yezehao/Compact-Continuum-Manipulator-Platform/Gantt-Chart/README.md

# 📋 Project Planning
This is the project planning section. The Gantt chart and Milestones about this project are listed as follow.
## Gantt Chart
```mermaid
gantt
    dateFormat  YYYY-MM-DD
    title MECH0064 MSc Group Project Gantt Chart

    Mataining this Gantt Chart [Z. Ye] : 2023-10-16, 2024-03-22

    section Preliminary Preparation [Z. Ye]
    Literature Review: done, 2023-10-23, 2023-12-31
    Work Package Distrubution: done, 2023-11-13, 5d
    Literature Review: milestone, crit, done, 2023-12-31, 0d 

    section Environment Config [Z. Ye]
    GitHub Config: done, 2023-11-6, 10d
    LaTex Config: done, 2023-11-13, 10d
    Docker Container Config: done, 2023-11-20, 25d
    Environment Configuration: milestone, done, crit, 2023-12-15, 0d 

    section Manipulator Modelling [D. Xu, J. Wu & Y. Zhang] 
    CAD Modelling (2D): done, 2023-11-18, 25d
    UG/Solidwork Modelling (3D): done, 2023-11-23, 25d
    Strain Analysis Replication: done, 2023-12-15, 40d
    Manipulator Model Strain Analysis: done, 2023-12-25, 55d
    Manipulator Model Parameter Adjustment: done, 2024-02-01, 2024-03-01
    Model Physical Strength Verification: milestone, crit, 2024-03-01, 0d 

    section Electronic Components Control [Y. Li & Y. Zhang]
    Proteus & Arduino IDE Env Config: done, 2023-11-18, 12d
    Auctutor Control Simulation: done, 2023-11-30, 10d
    Arduino Programming of Kinematics: done, 2023-12-11, 60d
    Arduino Programme Testing: done, 2024-02-01, 30d
    Arduino Bench Inspection: milestone, crit, 2024-03-01, 0d 

    section Locomotion Model [Z. Ye & Y. Zhu]
    Manipulator Parameter Design: done, 2023-11-18, 14d
    Forward Kinematics Algorithm: done, 2023-12-01, 30d
    Inverse Kinematics Algorithm: done, 2024-01-01, 60d
    Locomotion Bench Inspection: milestone, crit, 2024-03-08, 0d 

    section GitHub Documentation [Z. Ye]
    README Maintanence: active, 2023-10-16, 2024-03-15
    Manipulator Model Strain Analysis Documentation: active, 2024-01-20, 2024-03-15
    Arduino Programme Documentation: active, 2024-01-20, 2024-03-15
    Kinematics Programme Documentation: active, 2024-01-20, 2024-03-15
    Documentation Inspection: milestone, crit, 2024-03-15, 0d 

    section Deliverable
    Presentation 1 Preparation: done, 2023-12-06, 5d
    Presentation 1 [Week 16]: milestone, done, crit, 2023-12-11, 0d 
    Peer Assessment 1 [Week 16]: milestone, done, crit, 2023-12-18, 0d 
    Report Writting Preparation: done, 2024-02-26, 10d 
    Individual Contirbution [Week 28]: done, milestone, crit, 2024-03-08, 0d 
    Final Report [Week 28]: done, milestone, crit, 2024-03-08, 0d 
    Peer Assessment 2 [Week 28]: done, milestone, crit, 2024-03-08, 0d
    Presentation 2 preparation: 2024-03-15, 0d 
    Second Presentation [Week 29]: milestone, crit, 2024-03-15, 0d 
```

## Deadlines
<details closed>
<summary>Deadlines of project</summary>

|Assessment elements|Assessment Type|Contribution|Due Date|
|:--|:--|:--|:--|
|Presentation 1|Formative|Team|2023-12-11|
|Peer Assessment 1|Formative|Individual|2023-12-18|
|Final Report|Summative|Team|2024-03-08|
|Peer Assessment 2|Summative|Individual|2024-03-08|
|Individual Contribution|Summative|Individual|2024-03-08|
|Presentation 2|Summative|Team|2024-03-15|

</details>
