yezehao/Compact-Continuum-Manipulator-Platform/Deliverable/Final-Report/Main-Thesis-File.tex

\documentclass[12pt]{report} % 12 pt front size
\input{config/general.tex} % general config
\input{config/code-block.tex} % code block config
\input{config/flow-chart.tex} % flow chart config

\begin{document} % beginning of the document
\input{Section/Cover-Page} % Cover Page
\input{Section/Abstract} % Abstract
\input{Section/Contents-List} % Contents, List of Figures, and List of Tables
\input{Section/Introduction} % Introduction
\input{Section/Literature-Review} % Literature Review
\input{Section/Design} % Design
\input{Section/Result} % Result and Discussion
\input{Section/Evaluation} % Evaluation
\input{Section/Conclusion} % Conclusion

\setcounter{page}{1}
\renewcommand{\bibname}{References}
\addcontentsline{toc}{chapter}{References}
\pagenumbering{roman}
\pagestyle{plain}
% \printbibliography[title = {References}] % References
\bibliographystyle{unsrt}
\bibliography{references}{}
\newpage
\appendix
\input{Appendix/Appendix1} % Appendix 1
\input{Appendix/Appendix2} % Appendix 2
\input{Appendix/Appendix3} % Appendix 3
\input{Appendix/Appendix4} % Appendix 4
\input{Appendix/Appendix5} % Appendix 5

\end{document}
