yezehao/Compact-Continuum-Manipulator-Platform/Deliverable/Final-Report/Section/Cover-Page.tex

% ==================== Start of Cover Page ==================== %
\begin{titlepage}
\begin{center}
        \begin{center}
        
        \vspace{0.5cm}
        \end{center}
        \vspace*{0.1cm}
        % Title
        \vspace{2cm}
        {\LARGE\textbf{MECH0064 MSc Group Design Project\\}}

        % Sub-Title
        \vspace{2cm}
        {\huge\textbf{A Compact Continuum Robotics Manipulator for Applications in Therapeutic Ultrasound\\}}
        \vspace{0.25cm}
        % {\Huge\textbf{Manipulator Platform\\}}

        \vfill

        \begin{flushleft}
        \textbf{\emph{Group members:}} \\
        Zehao Ye (23119333)~~ Dawei Xu (23068563)\\ 
        Jiachen Wu (23212485)~~ Yuantong Li (23070439)\\ 
        Yuehan Zhang (23060335)~~ Yuhao Zhu (23041703)\\ 
        \textbf{\emph{Supervised by} Dr Reza Haqshenas} \\
        \vspace{5mm}
        \textbf{word count: 12,009}
        \end{flushleft}
        \vspace{0.8cm}
\end{center}
\end{titlepage}
% ==================== End of Cover Page ==================== %
