yezehao/Compact-Continuum-Manipulator-Platform/Deliverable/Final-Report/Appendix/Appendix2.tex

%%%%% Design %%%%%
\chapter{The Code Display}
\label{append:code_display}
\begin{figure}[H] %[H] "corresponds to start the figure Here" 
    \centering %alignment can be flushleft or flushright
    \captionsetup{labelsep=colon}
    \begin{subfigure}{\textwidth} % subfigure 2
        \centering
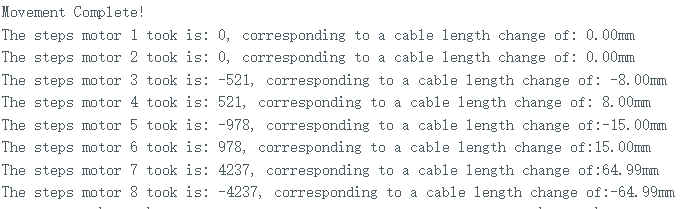
[picture p31: Deliverable/Final-Report/Image/Code-Display/arduino2.png]
        
        \caption{\centering the result of first stepping test}
        \label{fig:arduino_code_display_2}
    \end{subfigure}
    \begin{subfigure}{\textwidth} % subfigure 3
        \centering
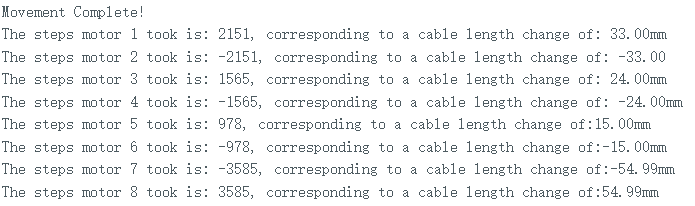
[picture p32: Deliverable/Final-Report/Image/Code-Display/arduino3.png]
        
        \caption{\centering the result of second stepping test}
        \label{fig:arduino_code_display_3}
    \end{subfigure}
    \caption[]
    {\centering \textbf{The Display of Arduino Control System.}}
    \label{fig:arduino_code_display}
\end{figure}

\begin{figure}[H] %[H] "corresponds to start the figure Here" 
    \centering %alignment can be flushleft or flushright
    \captionsetup{labelsep=colon}
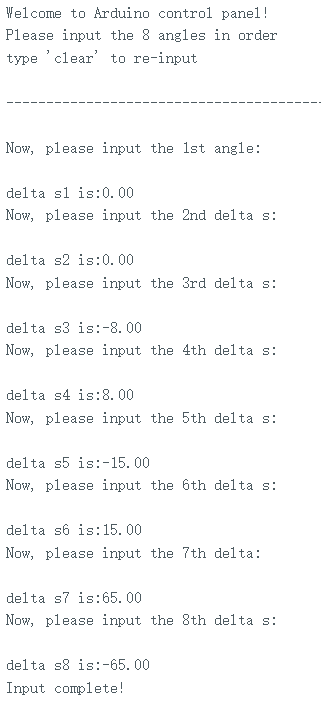
[picture p33: Deliverable/Final-Report/Image/Code-Display/arduino1.png]
    
    \caption[]
    {\centering \textbf{The input parameters for first stepping test.}}
    \label{fig:arduino_code_display_1}
\end{figure}

\begin{figure}[H] %[H] "corresponds to start the figure Here" 
    \centering %alignment can be flushleft or flushright
    \captionsetup{labelsep=colon}
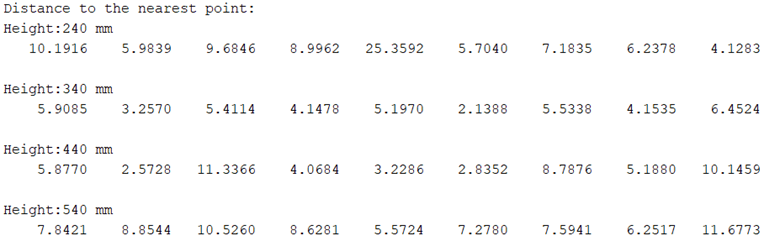
[picture p34: Deliverable/Final-Report/Image/Code-Display/matlab_240.png]
    
    \caption[]
    {\centering \textbf{The detection result while index=1000000 and H=240.}}
    \label{fig:matlab_240}
\end{figure}
\begin{figure}[H] %[H] "corresponds to start the figure Here" 
    \centering %alignment can be flushleft or flushright
    \captionsetup{labelsep=colon}
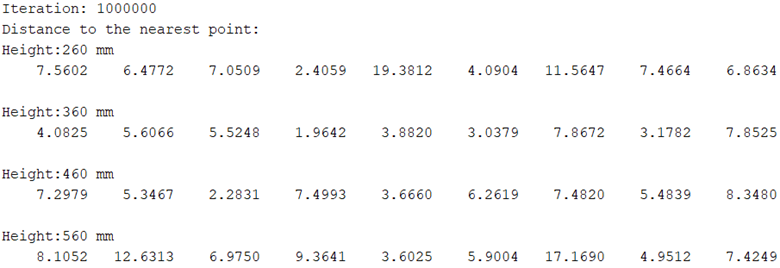
[picture p35: Deliverable/Final-Report/Image/Code-Display/matlab_260.png]
    
    \caption[]
    {\centering \textbf{The detection result while index=1000000 and H=260.}}
    \label{fig:matlab_260}
\end{figure}
\begin{figure}[H] %[H] "corresponds to start the figure Here" 
    \centering %alignment can be flushleft or flushright
    \captionsetup{labelsep=colon}
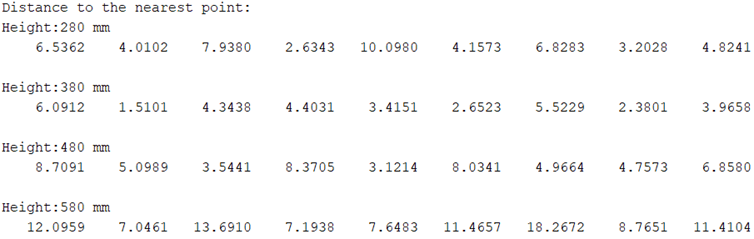
[picture p36: Deliverable/Final-Report/Image/Code-Display/matlab_280.png]
    
    \caption[]
    {\centering \textbf{The detection result while index=1000000 and H=280.}}
    \label{fig:matlab_280}
\end{figure}
\begin{figure}[H] %[H] "corresponds to start the figure Here" 
    \centering %alignment can be flushleft or flushright
    \captionsetup{labelsep=colon}
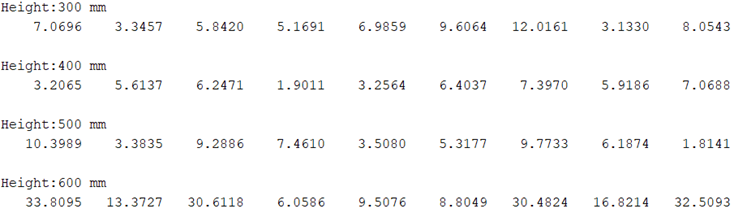
[picture p37: Deliverable/Final-Report/Image/Code-Display/matlab_300.png]
    
    \caption[]
    {\centering \textbf{The detection result while index=1000000 and H=300.}}
    \label{fig:matlab_300}
\end{figure}

% change to new page
\newpage
