yezehao/Compact-Continuum-Manipulator-Platform/Deliverable/Final-Report/config/flow-chart.tex

% This is the defination of flow chart
\usepackage{tikz}
\usetikzlibrary{arrows.meta, shapes.geometric}
\tikzset{%
     >={Latex[width=2mm,length=2mm]},
     % Specifications for style of nodes:
     base/.style = {rectangle, rounded corners, draw=black,
          minimum width=4cm, minimum height=1cm,
          text centered},
     activityStarts/.style = {base},
     startstop/.style = {base, fill=red!30},
     activityRuns/.style = {base},
     process/.style = {base, minimum width=2.5cm},
     data/.style = {rectangle, draw=black, minimum width=4cm, minimum height=1cm, 
          text centered, fill=orange!15},
     pending/.style = {diamond, draw=black, minimum width=1cm, minimum height=1cm, text centered, fill=blue!10},
}
