yezehao/Compact-Continuum-Manipulator-Platform/Deliverable/Final-Report/Image/MATLAB/manipulator_90_90_-90_-90.png

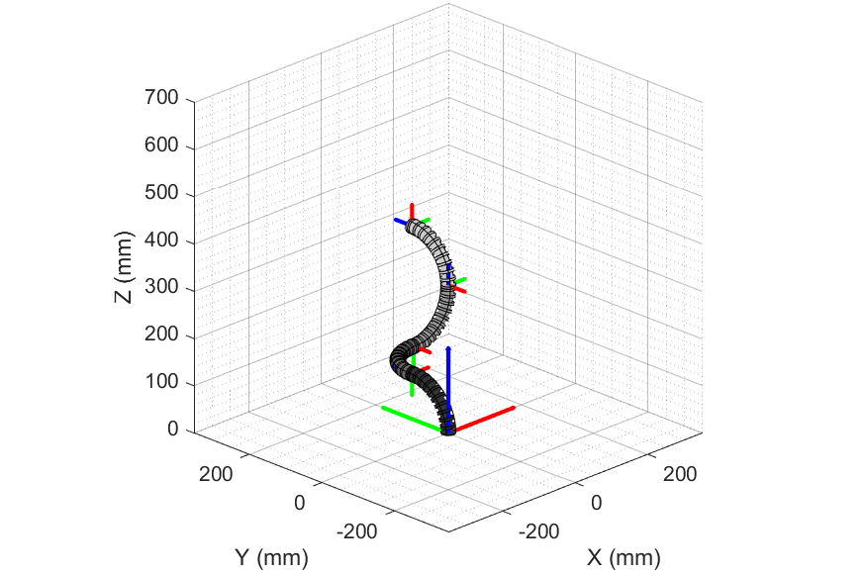
Deliverable/Final-Report/Image/MATLAB/manipulator_90_90_-90_-90.png
