yezehao/Compact-Continuum-Manipulator-Platform/Model/Manipulator.SLDASM

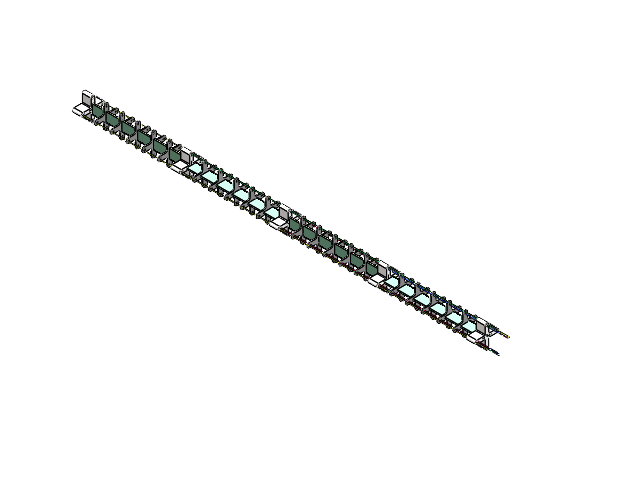
[picture p66: CAD file, 2024-03-07]
Model/Manipulator.SLDASM
Elastic sheet x 4
Soft sleeve x 4
Cross-shaped sheet x 20
Connector x 5
Cable x 8
