yezehao/Compact-Continuum-Manipulator-Platform/Deliverable/Final-Report/Section/Result.tex

%%%%% Result and Discussion %%%%%
\section{Result and Discussion} 
%%%%% Strength Analysis %%%%%
\subsection{Strength Analysis}
\subsubsection{The Result of Strength Analysis}
The strength analysis conducted using ANSYS has yielded the following results.
\begin{itemize}
    \item Displacement \\
    The maximum displacement observed in the manipulator was 117.44 mm, located at the end-effector, which is shown 
    in Figure \ref{fig:displacement}.
    \begin{figure}[H] % figure
        \centering 
        \captionsetup{labelsep=colon}
         
        \caption[The displacement analysis of manipulator]
        {\centering \textbf{The displacement analysis of manipulator.}}
        \label{fig:displacement}
    \end{figure}
    \item Stress \\
    As shown in Figure \ref{fig:stress}, the maximum stress was found to be 476.63 MPa, occurring at the base of 
    elastic sheet where the manipulator experiences the most significant load. 
    \begin{figure}[H] % figure
        \centering 
        \captionsetup{labelsep=colon}
         
        \caption[The stress analysis of manipulator]
        {\centering \textbf{The stress analysis of manipulator.}}
        \label{fig:stress}
    \end{figure}
\end{itemize}

The results indicate that Maximum stress is concentrated on the elastic sheet of the manipulator near the 
connector, which suggests that this is the most likely location for failure under the current design and 
loading conditions. The maximum von Mises stress did not exceed the typical yield strength of 65Mn alloy 
teel, indicating that the arm would return to its original shape after the removal of the load and there is 
no potential risk of plastic deformation or failure. This enhances the arm's reliability and extends its 
operational lifespan. 

Given that the material remains within its elastic limit, the design could potentially be optimized further 
to reduce weight or increase load capacity. Future work may explore these possibilities while maintaining 
the safety factors within the design criteria.
\subsubsection{Limitations and Solutions}
\begin{itemize}
    \item Simplification of the Model \\
    The initial analysis simplified the complex structure of the manipulator by focusing on a single module, 
    potentially overlooking critical interactions between various modules that contribute to the overall 
    strength and performance of the system. This simplification, while beneficial for computational efficiency, 
    may not accurately reflect the integrated behavior of the manipulator in real-world scenarios where interactions 
    between modules can significantly influence outcomes. 
    \textit{Solution}: Future analyses could incorporate the interactions between all modules to provide a more 
    comprehensive understanding of the manipulator's behavior under various conditions. Such an approach will 
    ensure a more accurate representation of the manipulator's behavior under various operational conditions, 
    leading to more reliable performance predictions and informed design decisions. 
    \item Failure Point Concentration \\
    Stress concentration at the base of the elastic sheet indicates a potential failure point but does not 
    account for fatigue or long-term wear. This oversight could underestimate the long-term durability of 
    the manipulator, potentially leading to unexpected maintenance issues or failure. \\
    \textit{Solution}: To address this gap, incorporating a detailed fatigue analysis into future work is 
    crucial. This analysis should evaluate the impact of repeated stress cycles on the manipulator's components 
    over extended periods. By understanding these effects, design modifications can be implemented to enhance 
    the durability and operational lifespan of the manipulator. The modifications could include optimizing 
    material selection, redesigning stress-prone areas to reduce concentration points, and introducing preventive 
    maintenance schedules based on predicted failure. 
    \item Impact of cables \\
    The analysis did not consider the impact of cable tension on the manipulator's strength. Cable tension 
    can significantly affect the manipulator's mechanical behavior. Neglecting this factor may lead to an 
    incomplete understanding of the manipulator's operational capabilities and potential failure modes. \\
    \textit{Solution}: Future analyses should integrate the effects of cable tension to achieve a more accurate 
    assessment of the manipulator's performance. This could involve modifying the existing model to include 
    boundary conditions that accurately represent the forces exerted by cables under various load scenarios. 
    Implementing dynamic simulations that account for variations in tension forces during different stages of 
    operation will further enhance the fidelity of the model. These improvements will enable a more nuanced 
    understanding of the manipulator's capabilities, assisting in the design of a more robust and reliable 
    system capable of withstanding the complexities of real-world applications. 
\end{itemize}
%%%%% Error Analysis %%%%%
\subsection{Error Analysis of Cross-Shaped Sheets}
At the early stage of the project, given that the number of cross-shape sheets in each module have an 
influence on the maximum bending angle $\boldsymbol{\alpha}_{max}$, which is an essential parameter of those which 
affect the workspace of the manipulator, hence the number of sheets should be determined by deriving 
the functions of both absolute error and relative error \cite{fishboneCR} against the number of sheets. The 
simulation results are shown in Figure \ref{fig:error_analysis}.
\begin{figure}[H] % figure
    \centering 
    \captionsetup{labelsep=colon}
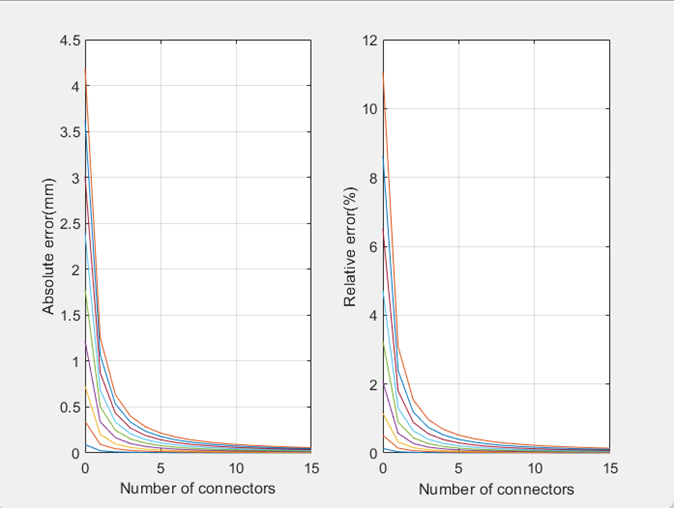
[picture p68: Deliverable/Final-Report/Image/Result/error_analysis.png]
     
    \caption[The simulation results of errors against the number of sheets]
    {\centering \textbf{The simulation results of errors against the number of sheets.}}
    \label{fig:error_analysis}
\end{figure}
As illustrated in Figure \ref{fig:error_analysis}, the changing trends of both absolute and 
relative errors are almost identical since 
the relative error is proportional to the absolute error, and the different lines with different colors represent 
the data with different bending angles whose range is from 10 degrees to 90 degrees in both directions (positive 
or negative). It is obvious that both errors decrease with the increase in the number of connecting sheets, hence 
theoretically, the number of sheets should be as large as possible to make both errors could be negligible. However, 
the number of sheets also has an influence on the size of simulation space, more the number of sheets less the size 
of simulation space given that if the length of manipulator is much longer, the space near to the basement of 
manipulator could not be reached due to the characteristics of the material. Hence, the number of sheets could be 
assumed to be 10 rather than 15, even though both the errors are smaller when the number of sheets is 15. 
%%%%% Workspace Analysis %%%%%
\subsection{Manipulator Workspace Analysis}
The workspace simulation of the manipulator has been illustrated since it is important to determine the 
variables of joints based on the required workspace. The segmented workspace is affected by several aspects, 
which include the simulation index and the range within the three-dimensional coordinates. The effective workspace 
of the manipulator is a cubic whose dimension is 300x300x300 (mm). The specific workspace has a fixed range on 
the x and y axes from -150 to 150 mm. Therefore, it is only necessary to determine the range of the workspace 
along the z-axis. The parameter H, representing the height of the basement of specific workspace, is 
utilized to determine the range of the workspace along the z-axis. The impacts of different indices and 
parameter H will be discussed separately, aiming to segment the appropriate cubic workspace of the manipulator.
\begin{figure}[H] % figure
    \centering 
    \captionsetup{labelsep=colon}
    \begin{subfigure}{0.45\textwidth} % subfigure 1
        \centering
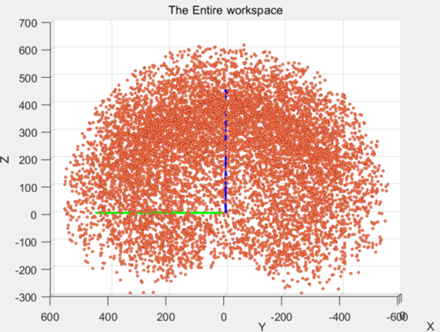
[picture p69: Deliverable/Final-Report/Image/Result/workspace_10000.png]
        
        \caption{\centering The entire workspace where simulation index=10000}
        \label{fig:ws_10000}
    \end{subfigure}
    \hfill
    \begin{subfigure}{0.45\textwidth} % subfigure 2
        \centering
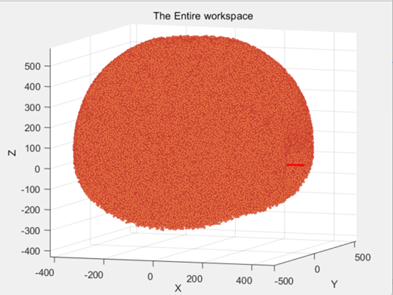
[picture p70: Deliverable/Final-Report/Image/Result/workspace_1000000.png]
        
        \caption{\centering The entire workspace where simulation index=1000000}
        \label{fig:ws_1000000}
    \end{subfigure}
    \caption[The entire workspace with different random indices]
    {\centering \textbf{The entire workspace with different simulation indices.}}
    \label{fig:ws_diff}
\end{figure}
\vspace{-5mm}
As shown in Figure \ref{fig:ws_10000}, the working space of manipulator forms a spherical shell-shaped 
point cloud consisting of 10000 floating points since the simulation index is 10000, which is insufficient to fully 
occupied the theoretical workspace. To further generalize the theoretical workspace, it is necessary to increase 
the simulation index. The appropriate workspace should be divided from the workspace whose index is 1000000. 
\begin{figure}[H] % figure
    \centering 
    \captionsetup{labelsep=colon}
    \begin{subfigure}{0.45\textwidth} % subfigure 2
        \centering
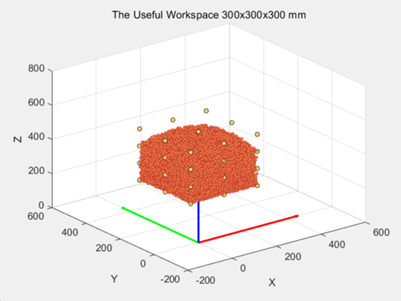
[picture p71: Deliverable/Final-Report/Image/Result/rect_workspace_1000000_350-650.png]
        
        \caption{\centering The cubic workspace of manipulator with index = 1000000 H=350-650 mm}
        \label{fig:ws_1000000_350}
    \end{subfigure}
    \hfill
    \begin{subfigure}{0.45\textwidth} % subfigure 1
        \centering
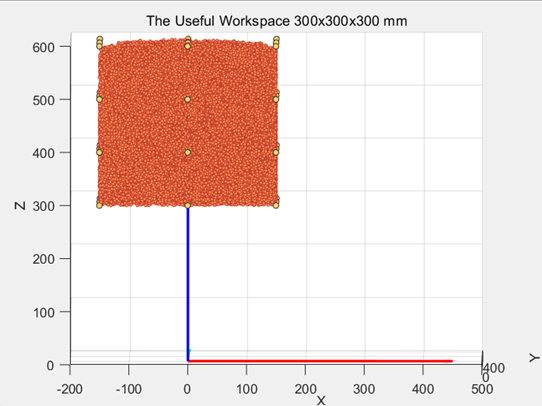
[picture p72: Deliverable/Final-Report/Image/Result/rect_workspace_1000000_300-600.png]
        
        \caption{\centering index = 1000000 H=300-600 mm}
        \label{fig:ws_10000_300}
    \end{subfigure}
    \caption[The cubic workspace with different segmentation]
    {\centering \textbf{The cubic workspace with different segmentation.}}
    \label{fig:ws_300_350}
\end{figure}
\vspace{-5mm}
Comparing the simulation results illustrated in Figure \ref{fig:ws_300_350}, it can be observed that the upper 
area of the segmented cubic workspace whose H=350mm failed to be occupied. However, the segmented cubic workspace 
whose H=300mm is almost fully occupied. To determine threshold of parameter H, a series of yellow detection points 
are utilized to test whether specific locations in the workspace can be reached. A programme is utilized to calculate 
the distance between the detection points and the simulated point cloud and identify the minimum distances. The  
simulation results whose index=1000000 and H=300mm are shown in Figure \ref{fig:matlab_300} in Appendix 
\ref{append:code_display}. The top view of the cubic workspace in Figure \ref{fig:top_view} associates labels with 
detection points, facilitating subsequent explanations. 
\begin{figure}[H] % figure
    \centering 
    \captionsetup{labelsep=colon}
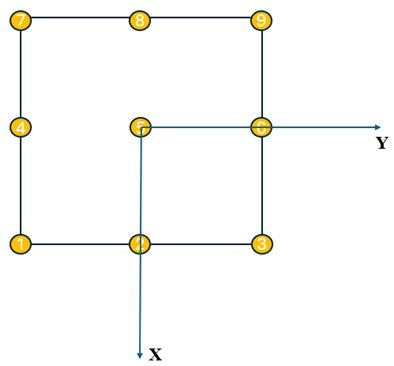
[picture p73: Deliverable/Final-Report/Image/Result/top_view_rect_workspace.png]
     
    \caption[The top view of the workspace and the labels of detection points]
    {\centering \textbf{The top view of the workspace and the labels of detection points.}}
    \label{fig:top_view}
\end{figure}
\vspace{-5mm}
While H=300 mm, The heights of the first, second, third, and fourth layers are 300 mm, 400 mm, 500 mm, and 600 mm, 
respectively. As the second and third layers are situated in the middle, theoretically all detection points on 
these two layers are reachable. Therefore, the mean and variance of distances to these points can be calculated. 
Combined with a normal distribution whose $\mu = 0$, a threshold is set to be 99.7\% of the data are within 3 
standard deviations of the mean can be derived to determine whether detection points on the first and fourth 
layers are reachable. The threshold $\tau$ can be calculated in Equation \ref{eq:threshold_reachable}. 
\begin{align}
    &\bar{d}_{2,3} = \sum_{i=2}^3 \sum_{j=1}^9 d_{ij,min} \nonumber \\
    &\sigma_{2,3}=\sqrt{\dfrac{1}{n}\times\sum_{i=1}^n(d_i-\bar{d})^2} \nonumber \\
    &\tau = \bar{d}_{2,3} + 3\times\sigma_{2,3}
    \label{eq:threshold_reachable}
\end{align}
The segmentation of the effective workspace for other values of H, specifically H=240, 260, and 280 mm, 
can also be performed using the same approach. The numerical values corresponding to different H parameters 
are illustrated in Figures \ref{fig:matlab_240}, \ref{fig:matlab_260}, \ref{fig:matlab_280} in Appendix 
\ref{append:code_display}. The results and reachability for different H are presented in Table 
\ref{tab:threshold_and_reachability}.
\begin{center}
    \small
    \begin{longtable}{l l l l l l }
    \caption{The Reachability of Detection Points with Different H.} \label{tab:threshold_and_reachability} \\
    \hline \multicolumn{1}{l}{\textbf{H (mm)}} & 
    \multicolumn{1}{l}{\textbf{Layer}} & 
    \multicolumn{1}{l}{\textbf{$\bar{d}_{2,3}$ (mm)}} & 
    \multicolumn{1}{l}{\textbf{$\sigma_{2,3}$ (mm)}} & 
    \multicolumn{1}{l}{\textbf{Threshold $\tau$ (mm)}} & 
    \multicolumn{1}{l}{\textbf{Reachability}} \\ \hline 
    \endfirsthead
    \multicolumn{6}{c}%
    {{\bfseries \tablename\ \thetable{} -- continued from previous page}} \\
    \hline \multicolumn{1}{l}{\textbf{H (mm)}} & 
    \multicolumn{1}{l}{\textbf{Layer}} & 
    \multicolumn{1}{l}{\textbf{$\bar{d}_{2,3}$}} & 
    \multicolumn{1}{l}{\textbf{$\sigma_{2,3}$}} & 
    \multicolumn{1}{l}{\textbf{Threshold $\tau$}} & 
    \multicolumn{1}{l}{\textbf{Reachability}} \\ \hline 
    \endhead
    \hline \multicolumn{6}{|r|}{{Continued on next page}} \\ \hline
    \endfoot
    \hline \hline
    \endlastfoot
    % table context
    300&1&5.79 & 2.50 & 13.29 &9 \\
       &4&5.79 & 2.50 & 13.29 &3 \\
    280&1&4.87 & 2.02 & 10.94 &9 \\
       &4&4.87 & 2.02 & 10.94 &4 \\
    260&1&5.37 & 2.01 & 11.41 &7 \\
       &4&5.37 & 2.01 & 11.41 &7 \\
    240&1&5.35 & 2.48 & 12.78 &8 \\
       &4&5.35 & 2.48 & 12.78 &9 \\
    \hline
    \end{longtable}
\end{center}
\vspace{-5mm}

As shown in Table \ref{tab:threshold_and_reachability}, setting H to 240 mm achieves better reachability, 
which is more reasonable compared to other scenarios. Additionally, to obtain a more accurate threshold, 
multiple tests or experimenting with a greater number of simulation indices can be undertaken to reduce random 
and systematic errors.
%%%%% INVERSE KINEMATICS %%%%%
\subsection{Inverse Kinematics}
This section will demonstrate the posture solution of single modules and trajectory replication results 
obtained through the IK algorithm. An in-depth analysis of accuracy and computational speed will be conducted, 
along with a discussion of its advantages and limitations. Using angles as input for the programme testing was 
preferred due to the complexity involved in specifying 12 indices of $\textbf{O}{target}$ and $\textbf{P}{target}$. 
%%%%% Singular Posture Solution %%%%%
\subsubsection{Posture Solution of Single Module Bending}
Firstly, the bending postures of each module were tested for the IK solution, and the 
specific results are presented in Table \ref{tab:single_posture_IK} in Appendix \ref{append:table}. The 
solutions of the Modules 3 and 4 were highly satisfactory, with Module 3 even converging to an error of 0.02 mm 
in 6 epochs. 

However, the results of the Modules 1 and 2 were unsatisfactory, which were caused by inappropriate 
initialization. According to the flowchart in Figure \ref{fig:flowchart}, the IK algorithm requires an 
initialization to start iterations. Take the example of the target with 
$\boldsymbol{\alpha} = [0,\ 90,\ 0,\ 0]\degree$, after initializing with the initial posture in Figure 
\ref{fig:kinematics model 0_0_0_0}, the first iteration of IK yielded a posture with 
$\boldsymbol{\theta} = [-0.0,\ 104.04,\ -0.0,\ -22.0]\degree$. Moreover, since each iteration starts from Module 4, 
the error in Module 4 cannot be eliminated. 

To mitigate this effect, selecting a more suitable posture for 
initialization is crucial. If the posture used for initialization with 
$\boldsymbol{\alpha} = [0,\ 100,\ 0,\ 0]\degree$, the solution of the IK algorithm would change to 
$\boldsymbol{\theta} = [-0.0,\ 81.77,\ -0.0,\ 9.3]\degree$. Nevertheless, due to errors generated by the 
iteration sequence, complete elimination remains challenging, and efforts were make to minimize the error to the 
greatest extent possible.  

Afterwards, the complex bending angles of modules was utilized as the target to investigate the influences of initialization. 
The target with angles $\boldsymbol{\alpha} = [80,\ 120,\ -120,\ 90]\degree$ was selected because its solution is complex, 
and it lies within the workspace of manipulator. The posture of the manipulator is shown in Figure 
\ref{fig:complex_target}. This scenario is likely to occur in practical applications and necessitates resolution 
through relevant methods. 

With the initialization using the initial posture, the solution was 
$\boldsymbol{\theta} = [-8.88, -89.99, -126.81, -169.73]\degree$, which is shown in Figure \ref{fig:complex_init_0_0_0_0}. 
However, the solution of IK algorithm was $\boldsymbol{\theta} = [84.98,\ 122.93,\ -114.9,\ 63.01]\degree$, 
which is significantly close to the target while the angles for initialization were $[85,\ 125,\ -115,\ 55]\degree$. 
The solution of the IK algorithm with more appropriate initialization is shown in Figure 
\ref{fig:complex_init_85_125_-115_55}. This signifies that if the manipulator is presently in a posture similar 
to the target configuration, it can accurately determine the corresponding bending angles $\boldsymbol{\theta}$ through the 
IK algorithm. This proved to be highly beneficial for trajectory replication. 
\begin{figure}[H] % figure
    \centering 
    \captionsetup{labelsep=colon}
    \begin{subfigure}{0.9\textwidth} % subfigure 1
        \centering
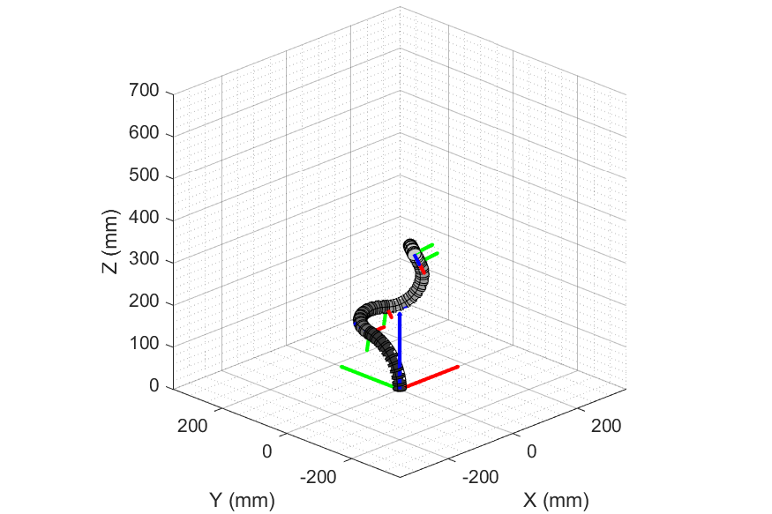
[picture p74: Deliverable/Final-Report/Image/MATLAB/manipulator_80_120_-120_90.png]
        
        \caption{\centering target: $\boldsymbol{\alpha} = [80,\ 120,\ -120,\ 90] \degree$ \\ \qquad}
        \label{fig:complex_target}
    \end{subfigure}
    \begin{subfigure}{0.49\textwidth} % subfigure 2
        \centering
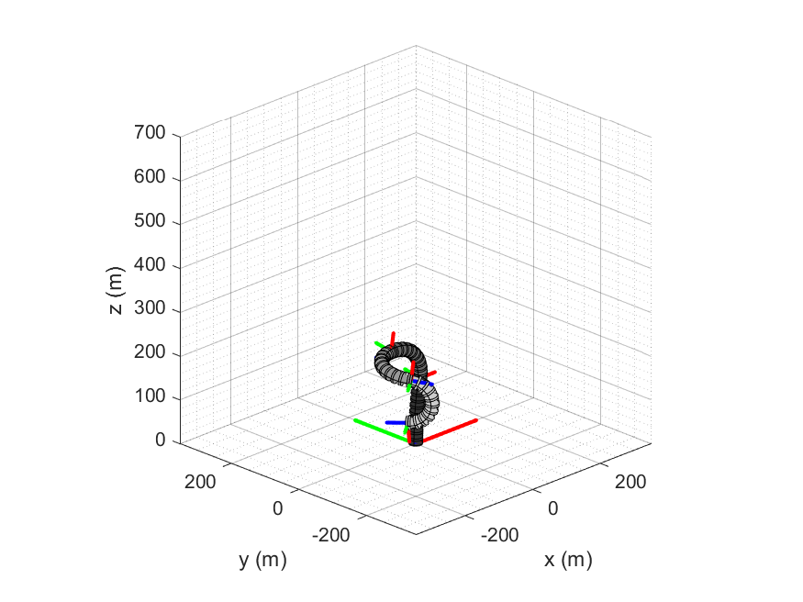
[picture p75: Deliverable/Final-Report/Image/MATLAB/manipulator_-8.88_-89.99_-126.81_-169.73.png]
        
        \caption{\centering initialization: $\boldsymbol{\alpha} = [0, 0, 0, 0]\degree$; \\
        $\boldsymbol{\theta} = [-8.88,\ -89.99,\ -126.81,\ -169.73]\degree$ }
        \label{fig:complex_init_0_0_0_0}
    \end{subfigure}
    \begin{subfigure}{0.49\textwidth} % subfigure 3
        \centering
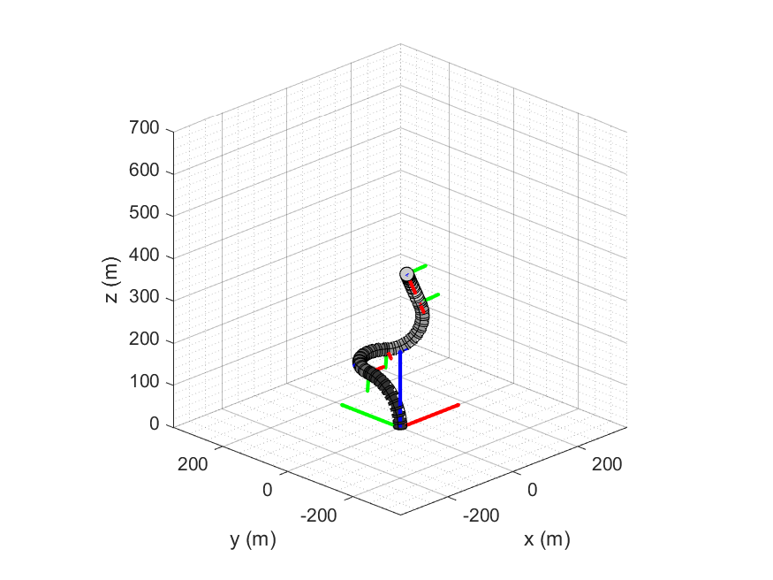
[picture p76: Deliverable/Final-Report/Image/MATLAB/manipulator_84.98_122.93_-114.9_63.01.png]
        
        \caption{\centering initialization: $\boldsymbol{\alpha} = [85, 125, -115, 55]\degree$; \\
        $\boldsymbol{\theta} = [84.98,\ 122.93,\ -114.9,\ 63.01]\degree$ }
        \label{fig:complex_init_85_125_-115_55}
    \end{subfigure}
    \caption[The kinematics model of manipulator with respective bending modules]
    {\centering \textbf{The inverse kinematics algorithm with different initialization.}}
    \label{fig:80_120_-120_90_diff_initial}
\end{figure}
\vspace{-5mm}
With the initialization using the initial posture, the solution was $\boldsymbol{\theta}$ = 
[-8.88, -89.99, -126.81, -169.73]$\degree$, which is shown in Figure \ref{fig:complex_init_0_0_0_0}. 
However, the solution of IK algorithm was $\boldsymbol{\theta} = [84.98,\ 122.93,\ -114.9,\ 63.01]\degree$, 
which is significantly close to the target while the angles for initialization were $[85,\ 125,\ -115,\ 55]\degree$. 
The solution of the IK algorithm with more appropriate initialization is shown in Figure 
\ref{fig:complex_init_85_125_-115_55}. This signifies that if the manipulator is presently in a posture similar 
to the target configuration, it can accurately determine the corresponding bending angles $\boldsymbol{\theta}$ through the 
IK algorithm.

Ultimately, The efficient computational capability of algorithm is one of its strengths. The algorithm only 
took 1.905 seconds to complete 10,000 epochs updating. In practical applications, it requires only 200 epochs 
to determine convergence. In comparison to traditional methods like inverse Jacobian \cite{inverse_jacobian}, 
which involve matrix transformations and derivatives, this approach provides potential solutions in a short 
time, addressing the issue of singular points. However, this method has its limitations. In scenarios with 
multiple segments, the algorithm may introduce significant errors due to the iteration order, and these errors 
were difficult to be eliminated. The only approach is to enhance the algorithm's performance through 
suitable initialization methods.
%%%%% Trajectory Replication %%%%%
\subsubsection{Trajectory Replication}
The preceding discussion has highlighted genetic method, which is utilizing the current posture for 
initialization in IK. In this phase, a comparison of different initializations aimed to 
highlight the benefits of incorporating genetic method in trajectory replication and planning for the IK 
algorithm. Subsequently, the IK algorithm with genetic method was employed to 
replicate two types of trajectories: arc segments and closed paths. This section will analyze the genetic 
method and these two trajectories, elucidating the strengths and weaknesses of inverse kinematics algorithm. 

The blue trajectory in Figure \ref{fig:genetic_approach} is the target trajectory, which bending from 
$\boldsymbol{\alpha} = [0,\ 0,\ 0,\ 0]$ to $\boldsymbol{\alpha} = [20,\ 20,\ 20,\ 20]$ equally in 20 steps. 
The red and purple trajectories are the replications using consistent initialization method and the genetic 
initialization method, respectively. The trajectory replication using the genetic method was comparatively better 
aligned with the target. The corrective effectiveness of the genetic algorithm was validated for 
other targets. The data of trajectories in Figure \ref{fig:genetic_approach} is listed in Table 
\ref{tab:trajectory_with_without_genetic}.
\begin{figure}[H] % figure
    \centering 
    \captionsetup{labelsep=colon}
     
    \caption[The trajectory replications with and without genetic method]
    {\centering \textbf{The trajectory replications with and without genetic method.}}
    \label{fig:genetic_approach}
\end{figure}
\vspace{-5mm}
The replicated trajectories of both target trajectories closely align, but there exists a certain degree of error. 
This discrepancy was attributed to the inclusion of the error threshold $\boldsymbol{\epsilon}$ set at 0.02 in the 
programme, allowing for computational efficiency while maintaining accuracy. However, when dealing with  
larger angular deviations, instances may arise where the replicated trajectories failed to precisely match the 
target trajectories. The average errors about the trajectory replication were calculated in Table \ref{tab:traj_average_errors}.
\vspace{-5mm}
\begin{center}
    \small
    \begin{longtable}{l l l}
    \caption{The Average Errors of the replicated trajectories.} \label{tab:traj_average_errors} \\
    \hline \multicolumn{1}{l}{\textbf{Replicated Trajectory}} & 
    \multicolumn{1}{l}{\textbf{$e_{average}$ (mm)}} & 
    \multicolumn{1}{l}{\textbf{$e_{average}$ (mm)}} \\ \hline 
    \endfirsthead
    \multicolumn{3}{c}%
    {{\bfseries \tablename\ \thetable{} -- continued from previous page}} \\
    \hline \multicolumn{1}{l}{\textbf{Replicated Trajectory}} & 
    \multicolumn{1}{l}{\textbf{$e_{average}$ (mm) of Figure \ref{fig:tr_cross}}} & 
    \multicolumn{1}{l}{\textbf{$e_{average}$ (mm) of Figure \ref{fig:tr_cross}}} \\ \hline 
    \endhead
    \hline \multicolumn{3}{|r|}{{Continued on next page}} \\ \hline
    \endfoot
    \hline \hline
    \endlastfoot
    % table context
    \textbf{total}	& 3.576157 & 6.415941 \\
    \textbf{in workspace}	& 1.032255 & 2.642474 \\
    \hline
    \end{longtable}
\end{center}
\begin{figure}[H] % figure
    \centering 
    \captionsetup{labelsep=colon}
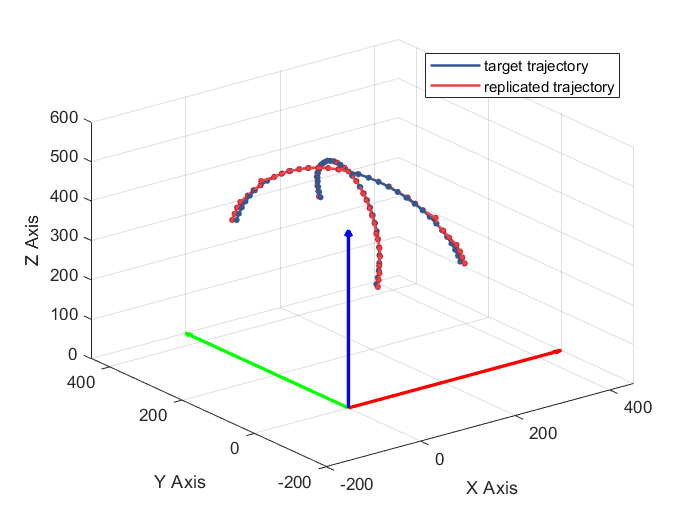
[picture p77: Deliverable/Final-Report/Image/Result/cross_trajectory_replication.png]
     
    \caption[The cross-shaped trajectory and its replication by IK algorithm]
    {\centering \textbf{The cross-shaped trajectory and its replication.}}
    \label{fig:tr_cross}
\end{figure}
\begin{figure}[H] % figure
    \centering 
    \captionsetup{labelsep=colon}
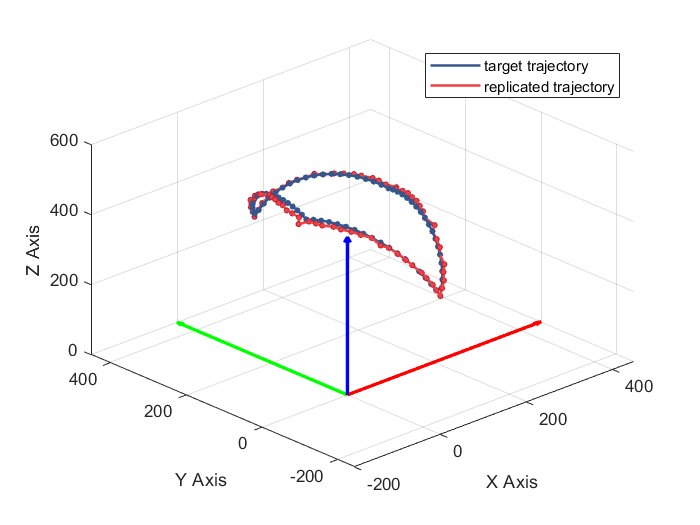
[picture p78: Deliverable/Final-Report/Image/Result/circle_trajectory_replication.png]
     
    \caption[The closed trajectory and its replication by IK algorithm]
    {\centering \textbf{The closed trajectory and its replication.}}
    \label{fig:clc_cross}
\end{figure}
%%%%% Limitation and Improvement %%%%%
\subsubsection{Limitation and Improvement}
However, it is challenging to calculate certain postures with IK algorithm. A method has 
been proposed involving continuous posture updating through a factor $f_u$. Nevertheless, this approach 
lacks systematic validation and is currently feasible only in specific circumstances. Therefore, it is 
mentioned here solely as a potential solution.

In practical applications, the initialization can be started with a relatively similar posture. 
In this context, the target where $\boldsymbol{\theta_{target}}$ = 
[45, 45, -45, -45] $\degree$ and the initialization with $\boldsymbol{\alpha_0}$ = [20, 20, -20, -20] $\degree$ 
were utilized to exemplify the corresponding calculations. The $\boldsymbol{target}$ is the position and 
orientation of the manipulator end effector.

The current posture with $\boldsymbol{\alpha_0}$  = [20, 20, -20, -20] $\degree$ was used as an initialization 
for calculations through IK algorithm, resulting in the solution $\boldsymbol{\theta_1}$. 
The difference between $\boldsymbol{\alpha_0}$ and $\boldsymbol{\theta_1}$ was calculated by $f_u = 0.5$ to acquire 
$\boldsymbol{\alpha_1}$, which is shown in Equation \ref{eq:alpha_0_to_1}.
\begin{align}
    &\boldsymbol{\theta_1} = \textbf{FABRIKc}(\boldsymbol{target}, \boldsymbol{\alpha_0}) 
    = [42.38, 73.25, -69.59, -62.85]\degree \nonumber \\
    &\boldsymbol{\alpha_1} = \boldsymbol{\alpha_0} + f_u \cdot (\boldsymbol{\theta_1} - \boldsymbol{\alpha_0}) 
    = [31.19, 46.63, -34.80, -41.43]\degree
    \label{eq:alpha_0_to_1}
\end{align}

The $\boldsymbol{\alpha_i}$ can be continuously updated according to the method, which the results yield in Equations 
\ref{eq:alpha_1_to_2},\ref{eq:alpha_2_to_3}, \ref{eq:alpha_3_to_4}, \ref{eq:alpha_4_to_5}, and \ref{eq:alpha_5_to_6}.
\begin{align}
    &\boldsymbol{\theta_2} = \textbf{FABRIKc}(\boldsymbol{target}, \boldsymbol{\alpha_1}) 
    = [56.95, 34.48, -56.40, -38.96]\degree \nonumber \\
    &\boldsymbol{\alpha_2} = \boldsymbol{\alpha_1} + f_u \cdot (\boldsymbol{\theta_2} - \boldsymbol{\alpha_1}) 
    = [44.07, 40.56, -45.60, -40.20]\degree
    \label{eq:alpha_1_to_2}
\end{align}
\vspace{-18mm}
\begin{align}
    &\boldsymbol{\theta_3} = \textbf{FABRIKc}(\boldsymbol{target}, \boldsymbol{\alpha_2}) 
    = [43.64, 51.49, -45.97, -48.84]\degree \nonumber \\
    &\boldsymbol{\alpha_3} = \boldsymbol{\alpha_2} + f_u \cdot (\boldsymbol{\theta_3} - \boldsymbol{\alpha_2}) 
    = [43.56, 46.03, -45.79, -44.52]\degree
    \label{eq:alpha_2_to_3}
\end{align}
\vspace{-18mm}
\begin{align}
    &\boldsymbol{\theta_4} = \textbf{FABRIKc}(\boldsymbol{target}, \boldsymbol{\alpha_3}) 
    = [46.22, 42.71, -45.9, -43.88]\degree \nonumber \\
    &\boldsymbol{\alpha_4} = \boldsymbol{\alpha_3} + f_u \cdot (\boldsymbol{\theta_4} - \boldsymbol{\alpha_3}) 
    = [44.89, 44.37, -45.85, -44.20]\degree
    \label{eq:alpha_3_to_4}
\end{align}
\vspace{-18mm}
\begin{align}
    &\boldsymbol{\theta_5} = \textbf{FABRIKc}(\boldsymbol{target}, \boldsymbol{\alpha_4}) 
    = [44.87, 45.23, -45.03, -45.30]\degree \nonumber \\
    &\boldsymbol{\alpha_5} = \boldsymbol{\alpha_4} + f_u \cdot (\boldsymbol{\theta_5} - \boldsymbol{\alpha_4}) 
    = [44.88, 44.80, -45.85, -44.20]\degree
    \label{eq:alpha_4_to_5}
\end{align}
\vspace{-18mm}
\begin{align}
    &\boldsymbol{\theta_6} = \textbf{FABRIKc}(\boldsymbol{target}, \boldsymbol{\alpha_5}) 
    = [45.08, 44.91, -45.09, -44.96]\degree \nonumber \\
    &\boldsymbol{\alpha_6} = \boldsymbol{\alpha_5} + f_u \cdot (\boldsymbol{\theta_6} - \boldsymbol{\alpha_5}) 
    = [44.94, 44.86, -45.47, -44.58]\degree
    \label{eq:alpha_5_to_6}
\end{align}

In addition, another approach involves manually adjusting the manipulator's posture through observation, 
which is relatively straightforward but lacks precision. It is important to note that due to orientation constraints, 
the sum of angles for modules 1 and 3 and modules 2 and 4 should remain constant during the adjustment process.
%%%%% ELECTRONIC CONTROL %%%%%
\subsection{Electronic Control}
%%%%% Actuation Control %%%%%
\subsubsection{Actuation Control}
Initially, the testing of the results was supposed to be carried out through Proteus simulation. However, 
it was discovered that during the simulation process in Proteus, the motor components did not function normally, 
with frequent occurrences of stepping errors. Meanwhile, the simulation could not be completed in real-time 
due to the heavy load on the computer CPU. After consideration, the team members purchased a complete set of real 
components for testing. In the real circuit, the pin that each motor occupies are listed in Table \ref{tab:stepmotor_pin} 
. 
\vspace{-5mm}
\begin{center}
    \small
    \begin{longtable}{c c c c c c c c c}
    \caption{The Pin Assignment of Stepper Motors.} \label{tab:stepmotor_pin} \\
    \hline \multicolumn{1}{l}{\textbf{Stepper Motor}} & 
    \multicolumn{1}{l}{\textbf{1}} & 
    \multicolumn{1}{l}{\textbf{2}} & 
    \multicolumn{1}{l}{\textbf{3}} & 
    \multicolumn{1}{l}{\textbf{4}} & 
    \multicolumn{1}{l}{\textbf{5}} & 
    \multicolumn{1}{l}{\textbf{6}} & 
    \multicolumn{1}{l}{\textbf{7}} & 
    \multicolumn{1}{l}{\textbf{8}} \\ \hline 
    \endfirsthead
    \multicolumn{9}{c}%
    {{\bfseries \tablename\ \thetable{} -- continued from previous page}} \\
    \hline \multicolumn{1}{l}{\textbf{Stepper Motor}} & 
    \multicolumn{1}{l}{\textbf{1}} & 
    \multicolumn{1}{l}{\textbf{2}} & 
    \multicolumn{1}{l}{\textbf{3}} & 
    \multicolumn{1}{l}{\textbf{4}} & 
    \multicolumn{1}{l}{\textbf{5}} & 
    \multicolumn{1}{l}{\textbf{6}} & 
    \multicolumn{1}{l}{\textbf{7}} & 
    \multicolumn{1}{l}{\textbf{8}} \\ \hline 
    \endhead
    \hline \multicolumn{9}{|r|}{{Continued on next page}} \\ \hline
    \endfoot
    \hline \hline
    \endlastfoot
    % table context
    \textbf{Pin} &22&30&38&46&23&31&39&47 \\
    \textbf{Pin} &24&32&40&48&25&33&41&49 \\
    \textbf{Pin} &26&34&42&50&27&35&43&51 \\
    \textbf{Pin} &28&36&44&52&29&37&45&53 \\
    \hline
    \end{longtable}
\end{center}
\vspace{-15mm}

After connecting the Arduino to the stepper motors as depicted in Figure \ref{fig:circuit_connection}, 
the programme is ready for execution.
\begin{figure}[H] % figure
    \centering 
    \captionsetup{labelsep=colon}
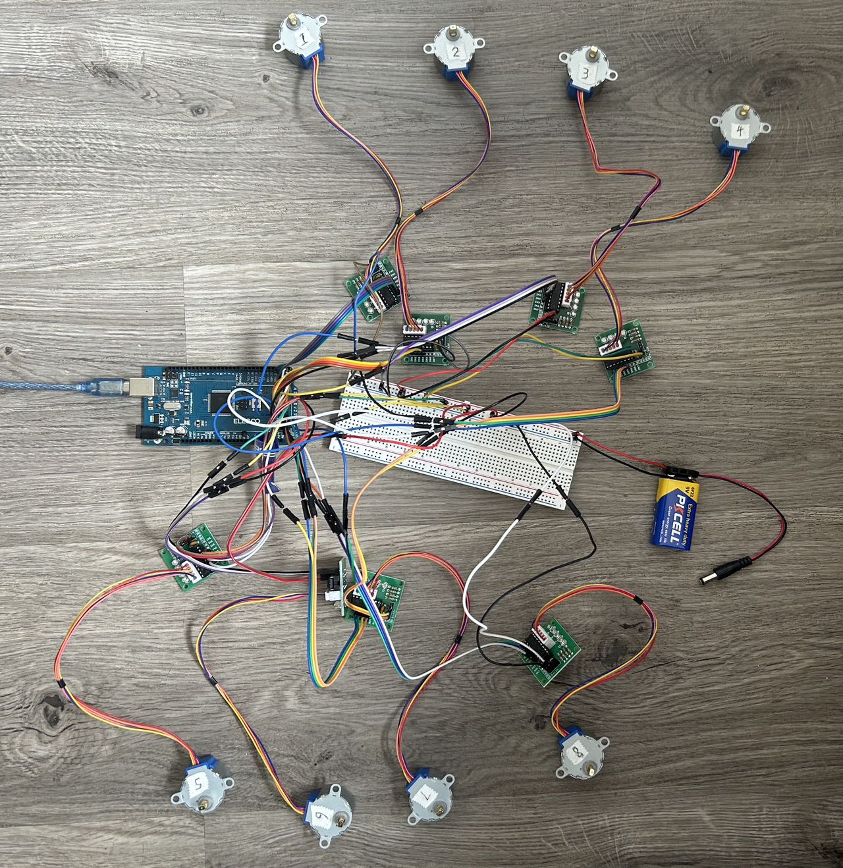
[picture p79: Deliverable/Final-Report/Image/Result/circuit_connection.jpg]
     
    \caption[The circuit connection of Arduino and stepper motors]
    {\centering \textbf{The circuit connection of Arduino and stepper motors.}}
    \label{fig:circuit_connection}
\end{figure}
\vspace{-5mm}
Users are required to sequentially input eight values of $\Delta S_1 \sim \Delta S_8$ to initiate 
the corresponding operation of the stepper motor. If the input is less than eight, the control system will 
not be executed. 

According to Figure \ref{fig:arduino_code_display_1} in Appendix \ref{append:code_display}, the change volume 
of cables are input into the Arduino program for execution, with the input data series being $\boldsymbol{\Delta S}$ 
= [0, 0, -8, 8, -15, 15, 65, -65] (mm). The value of $\Delta S_i$ is always in pairs, e.g, two cables controlling 
the same unit should always have the opposite $\Delta S_i$ value, this is decided by the working principle of the 
manipulator. After conversion, the corresponding $Step_1 \sim Step_8$ is [0, 0, -521, 521, -978, 978, 4237, -4237] 
(steps), where the “-” sign represents counterclockwise steps. Afterwards, the stepping can be finished in certain 
time. The function \emph{Serial.print(motor.currentPosition())} is utilized to check the steps of motors.

According to Figure \ref{fig:arduino_code_display_2} in Appendix \ref{append:code_display}, result of first testing 
is demonstrated, with all the motors are working appropriately. In this programme, all floating-point precision 
is taken to the $10^{-4}$ millimeter while the result printed on the monitor is $10^{-2}$ millimeter, 
which ensures that the accuracy of the result is acceptable.

Then, reset the motors, the motors went back to initial condition, which is $Step_1 \sim Step_8=0$. Repeat the 
motor stepping process, but this time, the motors are starting from a previous location from
$\boldsymbol{\Delta S_{now}}$ = [0, 0, -8, 8, -15, 15, 65, -65] (mm) to $\boldsymbol{\Delta S_{next}}$ = 
[33, -33, 16, -16, 0, 0, 10, -10] (mm). The difference $\boldsymbol{\Delta S_{diff}}$ = 
[33, -33, 24, -24, 15, -15, -55, 55] (mm), while the steps for motors are 
[2151, -2151, 1565, -1565, 978, -978, -3585, 3585] (steps). The result can be verified by checking how many 
revolutions each motor rotated in Figure \ref{fig:arduino_code_display_3} in Appendix \ref{append:code_display}.
The results are aligned with the calculation. Hence, the actuation control system runs correctly.
The Arduino programme is updated in GitHub repository.
{Arduino Simulation}.

Overall, the method of using Arduino to control the stepper motor and drive the manipulator is a feasible solution. 
Although the initial idea of using simulation software failed, the testing outcomes with real components solved this problem.

Additionally, from the perspective of test results, it can be observed that the precision of the stepper motors are 
beyond acceptable. In the 28YBJ-48 motor parameter settings, full stepping configuration implies that the motor is divided into 
2048 steps per revolution. For a rotor with a circumference of 31.416 mm, it provides a resolution of 
0.01534mm per step, which is more than enough to provide the accuracy required.

However, at the same time, there are some limitations to consider in this aspect. The most apparent limitation is that 
when cables wrap around the rotor, it effectively increases the diameter of the rotor, leading to minor errors. For a 
cable with a total length of 68 mm, it can wrap around the rotor twice. Assuming the cable has a thickness of 1 mm, this 
would introduce a maximum error of approximately $ 31.416 / (31.416 + 2) = 5\% $. Although in practice, it is unlikely 
that two layers of cable would perfectly stack on top of each other, this should be considered, because it's a factor 
that will cause errors. To solve this, an equation relating the length change of cables and the change in diameters 
should be deduced and applied in the programme to minimize the potential error, but due to limited time, this part was 
not finished. This factor needs to be considered in the further development process.

Furthermore, in this programme, only a rough setup for the stepper motor speed of the motors has been made. In reality, for 
achieving synchronization in starting/ending movement of each unit of the manipulator, more precise mathematical 
derivations for the motor speed is required. In the following development process, it would be helpful to 
associate the speed of stepper motors with the distance to the target position, thereby dynamically setting a 
speed value for each motor to accomplish this synchronization.

Ultimately, the input parameters of the control system are $\boldsymbol{\Delta S}$, which consist of eight indices. 
It is inconvenient for users to input a series of indices. The Arduino programme can be optimized to take the 
angles $\boldsymbol{\theta}$ as input parameters, which only require the users to input four parameters. The Python 
version programme is uploaded in the GitHub and ready to be converted into Arduino programme.
\subsubsection{Information Acquisition and Display}
In the design of the sensing and control section, the following functionalities have been implemented. 
\begin{itemize}
    \item Keyboard Input Control for Stepper Motor \\
    The system allows users to input commands via an upper computer keyboard to drive the stepper motor by specifying 
    the number of steps. The motor parameters are displayed on an LCD screen.
    \item MPU6050 Sensor for End-Effector Orientation \\
    The MPU6050 sensor collects the orientation angles of the manipulator’s end effector. The real-time data is displayed 
    on an OLED screen to assist users. The accuracy is controlled within 0.1°, meeting precision requirements. However, 
    prolonged sensor operation leads to increased internal chip temperature, resulting in noticeable noise and yaw zero-point 
    drift issues.
    \item HC-SR04 Ultrasonic Sensor for Distance Measurement \\
    The HC-SR04 ultrasonic sensor measures the distance from the manipulator’s end effector to the target object in 
    the polar coordinate system. The collected data is updated in real-time on the OLED screen to aid user operations. 
    The accuracy is effectively controlled within 3 mm, meeting precision requirements.
\end{itemize}

Due to the lack of a proper spatial coordinate detection system for the manipulator’s end effector, a closed-loop system has not 
been established in this project. The primary improvement task is to construct a closed-loop system, with the core technology 
being the determination of the end effector’s three-dimensional coordinates. Feasible solutions include:
\begin{itemize}
    \item Integration of Acceleration Data from MPU6050 \\
    The MPU6050 sensor detects acceleration along three axes. Integrating acceleration twice over time theoretically yields 
    displacement along these axes, which can further be used to derive spatial position coordinates. However, this approach 
    has limitations. Despite compensating for errors and drift, the results from double integration will rapidly accumulate 
    over time. Thus, relying solely on MPU6050 cannot provide accurate coordinate information for precise feedback in a 
    closed-loop system.
    \item Adding a Two-Degree-of-Freedom Gimbal at the End-Effector \\
    By attaching a gimbal with two degrees of freedom to the end-effector, the ultrasonic sensor can rotate vertically to face 
    three mutually perpendicular walls in the operating environment. The gimbal’s motor angles will be derived based on the 
    MPU6050’s orientation angles, ensuring that the ultrasonic sensor measures distances along the coordinate axes. However, 
    this approach assumes a workspace shaped like a rectangular prism with at least three perpendicular solid walls.
    \item Visual Processing Using Computer Vision \\
    Employing visual processing techniques, such as using cameras to track the sensor’s end effector, can derive distances 
    and further calculate coordinates based on phase focusing algorithms.
\end{itemize}

Among the three methods, the second approach has relatively low costs and minimal implementation difficulty. Once the 
end effector’s coordinates are obtained, combining them with the MPU6050’s orientation data allows for closed-loop control 
feedback. Additionally, considering that the MPU6050 performs best in low-temperature environments, measures such as 
chip cooling are necessary.

% change to new page
\newpage
