yezehao/Compact-Continuum-Manipulator-Platform/Arduino-Simulation/Sensor-Display/MPU6050/serial monitor shows the results of real part virification.jpg

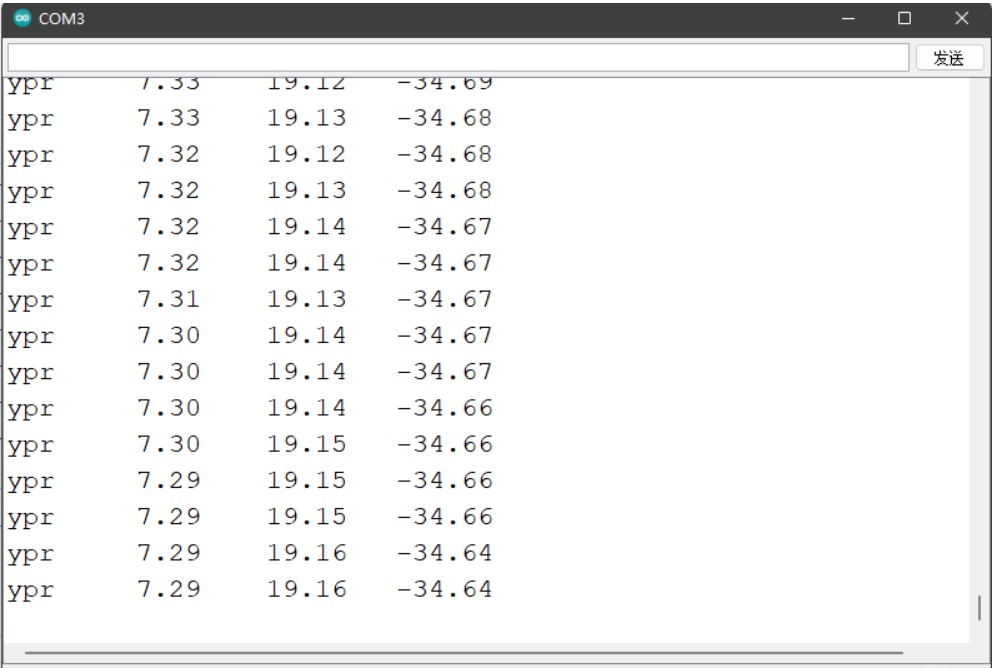
Arduino-Simulation/Sensor-Display/MPU6050/serial monitor shows the results of real part virification.jpg
