yezehao/Compact-Continuum-Manipulator-Platform/Deliverable/Final-Report/Image/Result/circle_trajectory_replication_by_FABRIKc.png

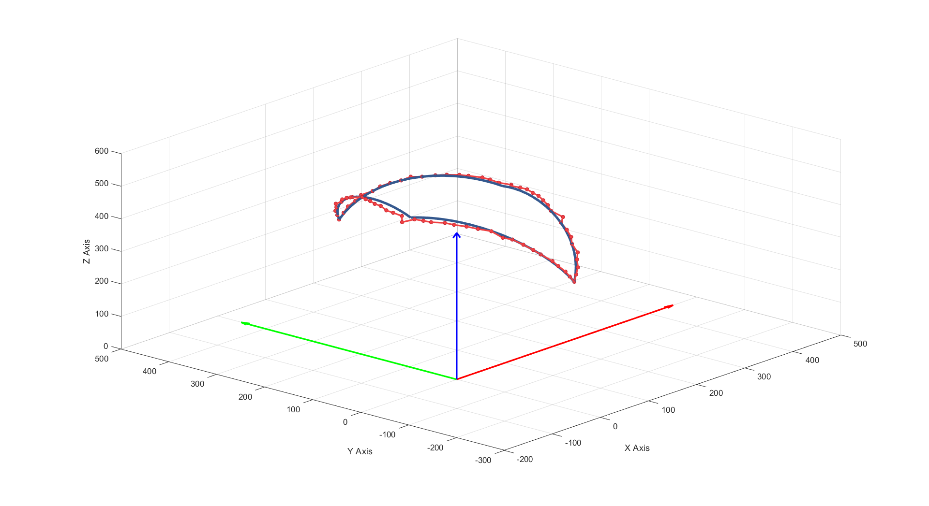
Deliverable/Final-Report/Image/Result/circle_trajectory_replication_by_FABRIKc.png
