yezehao/Compact-Continuum-Manipulator-Platform/Deliverable/Final-Report/Image/Result/cross_trajectory_replication_by_FABRIKc.png

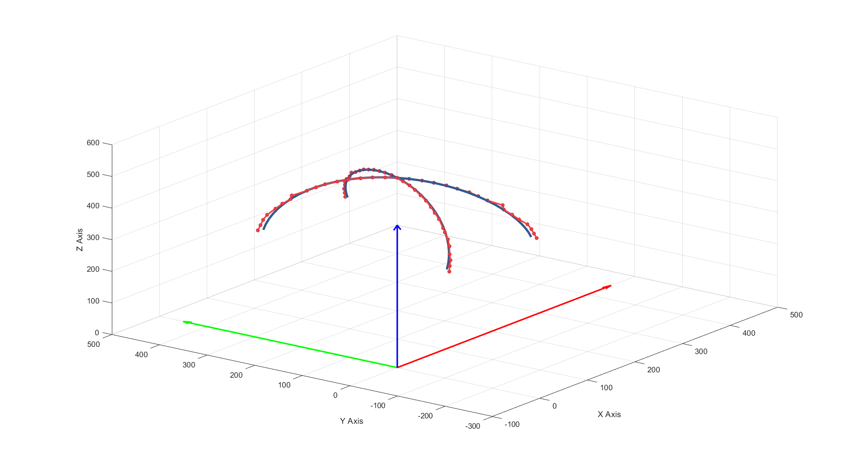
Deliverable/Final-Report/Image/Result/cross_trajectory_replication_by_FABRIKc.png
