yezehao/Compact-Continuum-Manipulator-Platform/Deliverable/Final-Report/Image/Result/cross_trajectory_replication_with_label.png

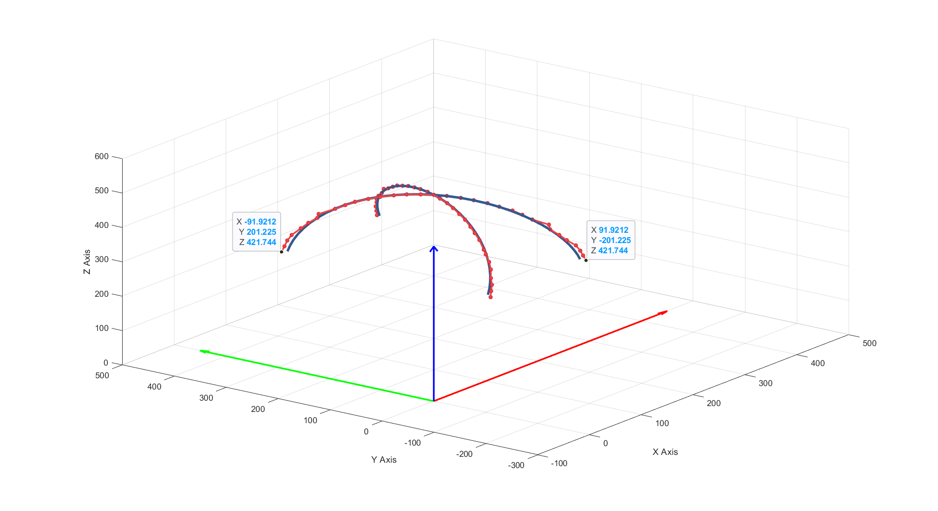
Deliverable/Final-Report/Image/Result/cross_trajectory_replication_with_label.png
