yezehao/Compact-Continuum-Manipulator-Platform/MATLAB/result/TR_diff_init.png

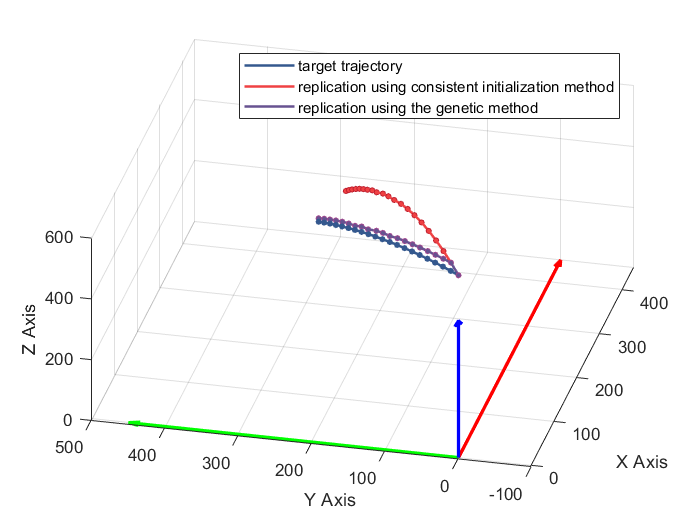
MATLAB/result/TR_diff_init.png
