yezehao/Compact-Continuum-Manipulator-Platform/(list of files, drawings)

Other design files:
Arduino-Simulation/Actuation-Control/multiple_motor_control.pdsprj
Arduino-Simulation/Sensor-Display/MPU6050/Mpu 6050.pdsprj
Arduino-Simulation/Sensor-Display/OLED+ToF/oled + tof.pdsprj
Arduino-Simulation/Sensor-Display/OLED+ToF/Project Backups/oled + tof [20240312, 20-38-15].pdsprj
