yezehao/Compact-Continuum-Manipulator-Platform/(commit log)

2023-12-06 Updated motor control schematics
    including script for arduino and proteus schematics
    [multiple_motor_control.pdsprj]
2023-12-07 add some result about kinematics
2023-12-09 update the function of forward kinematic matrix
2023-12-12 udpate the forward kinematics matrices function
2023-12-15 udpate the methodology about kinematics
2023-12-17 udpate the forward kinematics algorithm'
2023-12-19 update the result about workspace
    [60degree_bending_workspace.csv, 90degree_bending_workspace.csv, maximum_bending_workspace.csv]
2023-12-29 rename the programme about forward kinematics
2023-12-31 add the inverse kinematics test programme
2024-01-02 udpate the inverse kinematics programme
2024-01-08 update the programme about forward kinematics
2024-01-08 add note about the inverse kinematics
2024-01-22 remove the inverse kinematics test programme
2024-01-23 add file for kinematics programme using python
2024-01-23 add the programme of forward kinematics in python version
2024-01-28 Added conversion.py
    Convert angles to the change of cable lengths
2024-02-01 add tutorials about the kinematics programme
2024-02-05 move the proteus programme into Arduino-Simulation folder
    [multiple_motor_control.pdsprj]
2024-02-05 move the programme out of src
    [multiple_motor_control.pdsprj]
2024-02-07 update the programme about inverse kinematics visualization
2024-02-07 update the programme about forward kinematics visualization
2024-02-26 add the inverse kinematics algorithm FABRIKc
2024-02-29 move the note into Kinematics file
2024-03-01 update the README FILE about kinematics
2024-03-01 update the forward kinematics juypter notebook
2024-03-03 update the inverse kinematics programme
2024-03-03 update forward kinematics programme
2024-03-03 add the inverse kinematics programmes using ANN
2024-03-04 add config for flow chart
2024-03-05 update the kinematics algorithm
2024-03-06 update the kinematics algorithm in MATLAB
2024-03-07 Updated Arduino circuit layout and program algorithm
    Image update
2024-03-07 Uploaded the Arduino code
    motor_control_final.ino
2024-03-07 add the CAD model of manipulator, this part is done by Dawei and Jiachen
    [Manipulator.SLDASM]
2024-03-07 update the result of report
    [Manipulator.SLDASM]
2024-03-11 Update README.md for Kinematics
2024-03-11 update the programme about kinematics
2024-03-11 update the README about Kinematics
2024-03-12 add README.md about Arduino
2024-03-12 remove README.md about Arduino
2024-03-12 Create sensor & screen display
2024-03-13 remove the sensor and screen display
2024-03-13 add the arduino programme about sensor and display
    [Mpu 6050.pdsprj, oled + tof [20240312, 20-38-15].pdsprj, oled + tof.pdsprj]
2024-03-13 rename the motor control programme
2024-03-13 remove the file into actuation control folder
    [multiple_motor_control.pdsprj]
2024-03-13 add README.md about sensor and display
2024-03-13 rename the programme
    [oled + tof [20240312, 20-38-15].pdsprj, oled + tof.pdsprj]
2024-03-13 rename the file
    [oled + tof [20240312, 20-38-15].pdsprj, oled + tof.pdsprj]
